SVZinoviev/radio-piper-lo-pll-hw/README.md

# 100 - 200 MHz PLL

## Intended use

Radio LO1 and LO2 configurable synthesizer.

## Configuration

VCO can work in the wide range 10 MHz - 200+ MHz
