SVZinoviev/radio-piper-lo-pll-hw/vco-100-200.kicad_pcb

## KiCad design vco-100-200.kicad_pcb (2026-02-13)

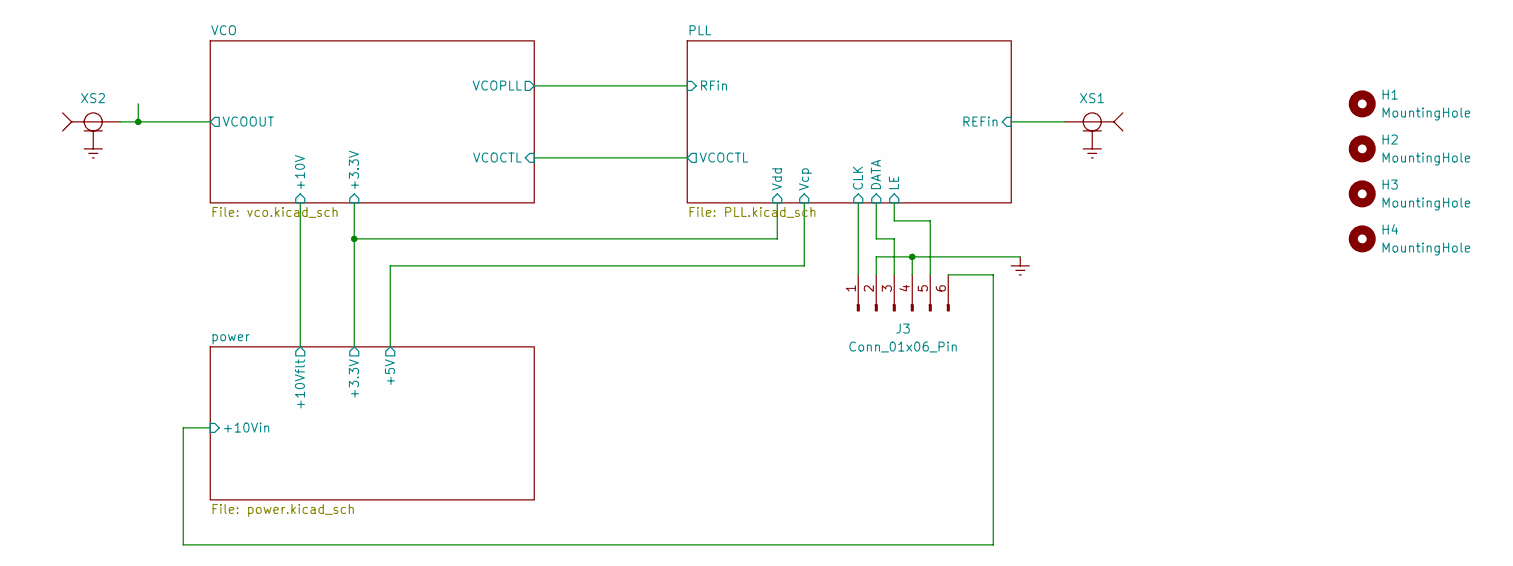
[picture p1: schematic vco-100-200.kicad_sch]

Parts:
H1, H2, H3, H4: MountingHole; MountingHole_3.2mm_M3
J3: Conn_01x06_Pin; PinHeader_1x06_P2.54mm_Vertical
XS1, XS2: RF-PCB-pin-place

Connections:
/PLL/CLK: J3.1; also elsewhere on the board
/PLL/DATA: J3.3; also elsewhere on the board
/PLL/LE: J3.5; also elsewhere on the board
/PLL/REFin: XS1.1; also elsewhere on the board
/VCO/VCOOUT: XS2.1; also elsewhere on the board
/power/+10Vin: J3.6; also elsewhere on the board
Earth: J3.2, J3.4, XS1.2, XS2.2; also elsewhere on the board

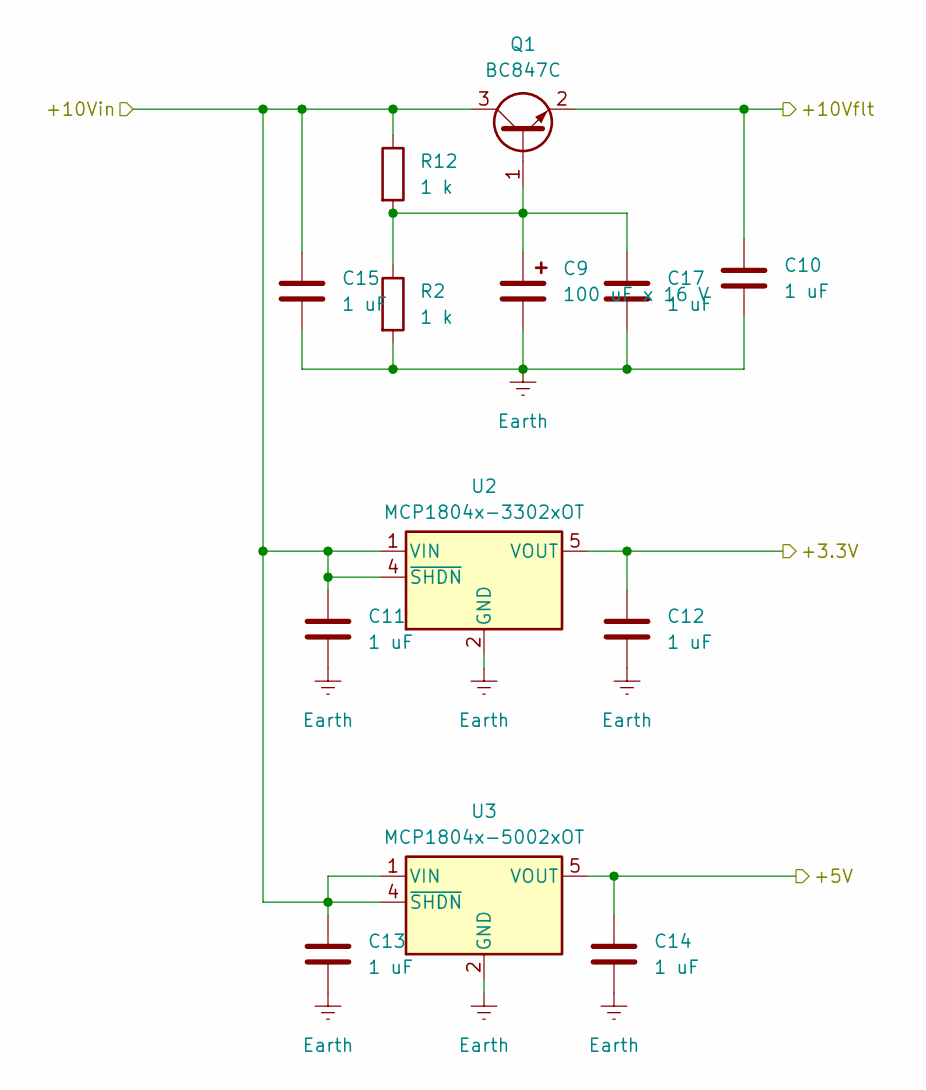
[picture p2: schematic power.kicad_sch]

Parts:
C9: 100 uF x 16 V; CP_Elec_6.3x5.8; Partnumber UCD1C101MCL1GS
C10, C11, C12, C13, C14, C15, C17: 1 uF; C_0603_1608Metric; Partnumber GCM188R71C105KA64D
Q1: BC847C; SOT-23; Partnumber BC847C
R2, R12: 1 k; R_0603_1608Metric; Partnumber RC0603JR-071K00L
U2: MCP1804x-3302xOT; SOT-23-5
U3: MCP1804x-5002xOT; SOT-23-5

Connections:
/PLL/Vcp: C14.1, U3.5 (VOUT); also elsewhere on the board
/PLL/Vdd: C12.1, U2.5 (VOUT); also elsewhere on the board
/VCO/+10V: C10.1, Q1.2 (E); also elsewhere on the board
/power/+10Vin: C11.1, C13.1, C15.1, Q1.3 (C), R12.1, U2.1 (VIN), U2.4 (~SHDN), U3.1 (VIN), U3.4 (~SHDN); also elsewhere on the board
Earth: C9.2, C10.2, C11.2, C12.2, C13.2, C14.2, C15.2, C17.2, R2.2, U2.2 (GND), U3.2 (GND); also elsewhere on the board
unnamed: C9.1, C17.1, Q1.1 (B), R2.1, R12.2

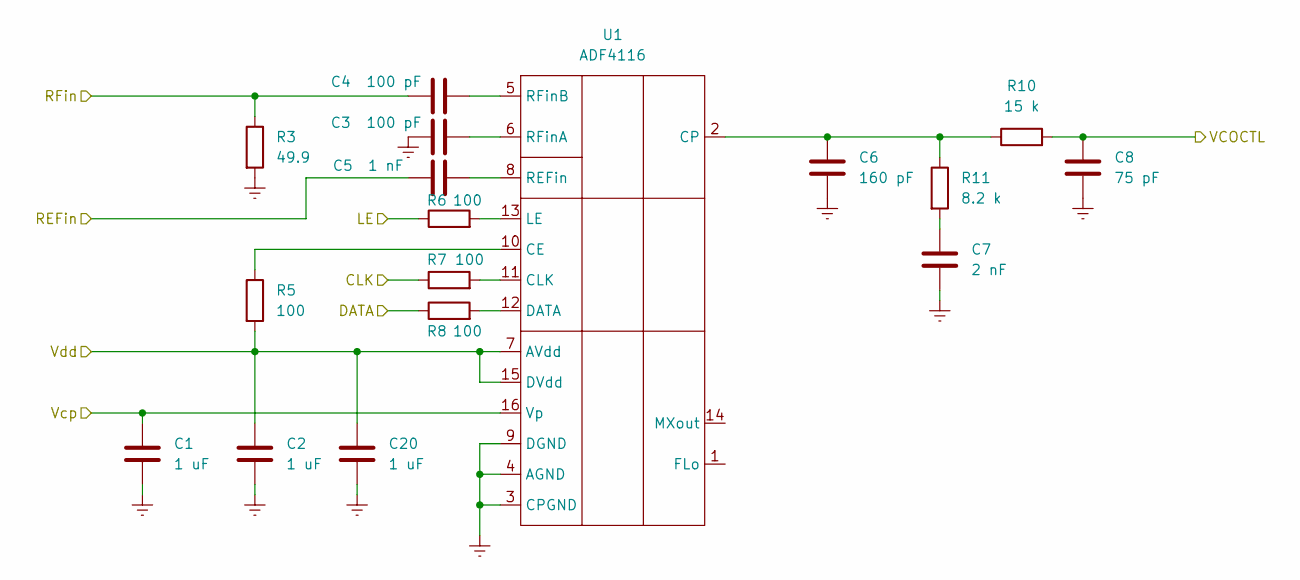
[picture p3: schematic PLL.kicad_sch]

Parts:
C1, C2, C20: 1 uF; C_0603_1608Metric; Partnumber GCM188R71C105KA64D
C3, C4: 100 pF; C_0603_1608Metric; Partnumber CC0603JRNPO9BN101
C5: 1 nF; C_0603_1608Metric; Partnumber CC0603JRNPO9BN102
C6: 160 pF; C_0603_1608Metric; Partnumber GCM1885C2A161GA16J
C7: 2 nF; C_0603_1608Metric; Partnumber GRM1885C1H222JA01D
C8: 75 pF; C_0603_1608Metric; Partnumber GCM1885C2A750JA16D
R3: 49.9; R_0603_1608Metric; Partnumber RC0603FR-0749R9L
R5, R6, R7, R8: 100; R_0603_1608Metric; Partnumber RC0603JR-07100RL
R10: 15 k; R_0603_1608Metric; Partnumber RC0603JR-0715K0L
R11: 8.2 k; R_0603_1608Metric; Partnumber RC0603FR-078K2L
U1: ADF4116; TSSOP-16_4.4x5mm_P0.65mm; Partnumber ADF4116BRUZ

Connections:
/PLL/CLK: R7.1; also elsewhere on the board
/PLL/DATA: R8.1; also elsewhere on the board
/PLL/LE: R6.1; also elsewhere on the board
/PLL/REFin: C5.2; also elsewhere on the board
/PLL/RFin: C4.1, R3.1; also elsewhere on the board
/PLL/VCOCTL: C8.1, R10.2; also elsewhere on the board
/PLL/Vcp: C1.1, U1.16 (Vp); also elsewhere on the board
/PLL/Vdd: C2.1, C20.1, R5.2, U1.7 (AVdd), U1.15 (DVdd); also elsewhere on the board
Earth: C1.2, C2.2, C3.1, C6.2, C7.2, C8.2, C20.2, R3.2, U1.3 (CPGND), U1.4 (AGND), U1.9 (DGND); also elsewhere on the board
unnamed: C7.1, R11.2
unnamed: R5.1, U1.10 (CE)
unnamed: R7.2, U1.11 (CLK)
unnamed: C6.1, R10.1, R11.1, U1.2 (CP)
unnamed: R8.2, U1.12 (DATA)
unnamed: R6.2, U1.13 (LE)
unnamed: C5.1, U1.8 (REFin)
unnamed: C3.2, U1.6 (RFinA)
unnamed: C4.2, U1.5 (RFinB)

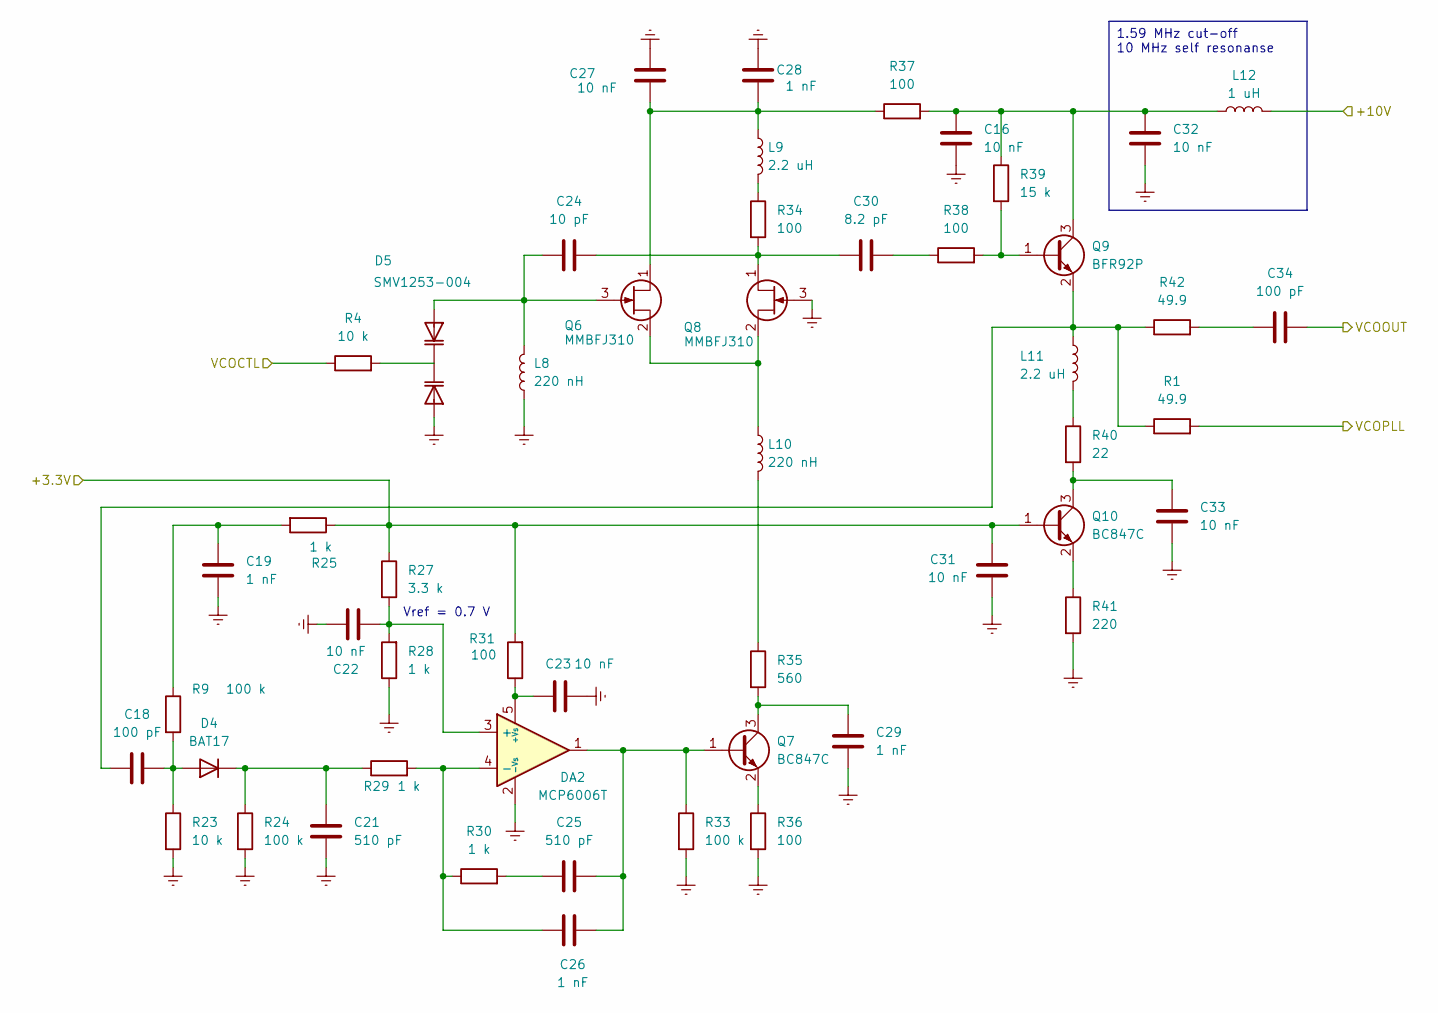
[picture p4: schematic vco.kicad_sch]

Parts:
C16, C22, C23, C27, C31, C32, C33: 10 nF; C_0603_1608Metric; Partnumber CC0603JRNPO9BN103
C18, C34: 100 pF; C_0603_1608Metric; Partnumber CC0603JRNPO9BN101
C19, C26, C28, C29: 1 nF; C_0603_1608Metric; Partnumber CC0603JRNPO9BN102
C21, C25: 510 pF; C_0603_1608Metric; Partnumber CC0603JRNPO9BN511
C24: 10 pF; C_0603_1608Metric; Partnumber CC0603JRNPO9BN100
C30: 8.2 pF; C_0603_1608Metric; Partnumber CC0603JRNPO9BN8R2
D4: BAT17; SOT-23; Partnumber BAT17E6327HTSA1
D5: SMV1253-004; SOT-23; Partnumber SMV1253-004LF
DA2: MCP6006T; SOT-23-5
L8, L10: 220 nH; L_1008_2520Metric; Partnumber LQW2BASR22J00L
L9, L11: 2.2 uH; L_1008_2520Metric; Partnumber LQW2UAS2R2J00L
L12: 1 uH; L_0603_1608Metric; Partnumber MLZ1608A1R0WT000
Q6, Q8: MMBFJ310; SOT-23; Partnumber MMBFJ310
Q7, Q10: BC847C; SOT-23; Partnumber BC847C
Q9: BFR92P; SOT-23; Partnumber BFR92PE6327HTSA1
R1, R42: 49.9; R_0603_1608Metric; Partnumber RC0603FR-0749R9L
R4, R23: 10 k; R_0603_1608Metric; Partnumber RC0603JR-0710K0L
R9, R24, R33: 100 k; R_0603_1608Metric; Partnumber RC0603JR-07100KL
R25, R28, R29, R30: 1 k; R_0603_1608Metric; Partnumber RC0603JR-071K00L
R27: 3.3 k; R_0603_1608Metric; Partnumber RC0603JR-073K30L
R31, R34, R36, R37, R38: 100; R_0603_1608Metric; Partnumber RC0603JR-07100RL
R35: 560; R_0603_1608Metric; Partnumber RC0603JR-07560RL
R39: 15 k; R_0603_1608Metric; Partnumber RC0603JR-0715K0L
R40: 22; R_0603_1608Metric; Partnumber RC0603JR-0722RL
R41: 220; R_0603_1608Metric; Partnumber RC0603JR-07220RL

Connections:
/PLL/RFin: R1.2; also elsewhere on the board
/PLL/VCOCTL: R4.1; also elsewhere on the board
/PLL/Vdd: C31.2, Q10.1 (B), R25.1, R27.1, R31.2; also elsewhere on the board
/VCO/+10V: L12.2; also elsewhere on the board
/VCO/VCOOUT: C34.2; also elsewhere on the board
Earth: C16.2, C19.2, C21.1, C22.1, C23.2, C27.2, C28.2, C29.2, C31.1, C32.2, C33.2, D5.2 (A2), DA2.2 (-Vs), L8.1, Q8.3 (G), R23.2, R24.2, R28.1, R33.2, R36.2, R41.2; also elsewhere on the board
unnamed: C19.1, R9.1, R25.2
unnamed: C25.1, R30.2
unnamed: C30.2, R38.1
unnamed: C34.1, R42.2
unnamed: C18.2, D4.1 (A), R9.2, R23.1
unnamed: C21.2, D4.3 (K), R24.1, R29.1
unnamed: C24.1, D5.1 (A1), L8.2, Q6.3 (G)
unnamed: D5.3 (K), R4.2
unnamed: C22.2, DA2.3 (+), R27.2, R28.2
unnamed: C23.1, DA2.5 (+Vs), R31.1
unnamed: C26.1, DA2.4 (-), R29.2, R30.1
unnamed: L9.2, R34.1
unnamed: L10.2, R35.1
unnamed: L11.2, R40.1
unnamed: C27.1, C28.1, L9.1, Q6.1 (D), R37.1
unnamed: L10.1, Q6.2 (S), Q8.2 (S)
unnamed: C25.2, C26.2, DA2.1, Q7.1 (B), R33.1
unnamed: C29.1, Q7.3 (C), R35.2
unnamed: Q7.2 (E), R36.1
unnamed: C24.2, C30.1, Q8.1 (D), R34.2
unnamed: Q9.1 (B), R38.2, R39.2
unnamed: C16.1, C32.1, L12.1, Q9.3 (C), R37.2, R39.1
unnamed: C18.1, L11.1, Q9.2 (E), R1.1, R42.1
unnamed: C33.1, Q10.3 (C), R40.2
unnamed: Q10.2 (E), R41.1

Notes on the sheet:
Vref = 0.7 V
1.59 MHz cut-off 10 MHz self resonanse

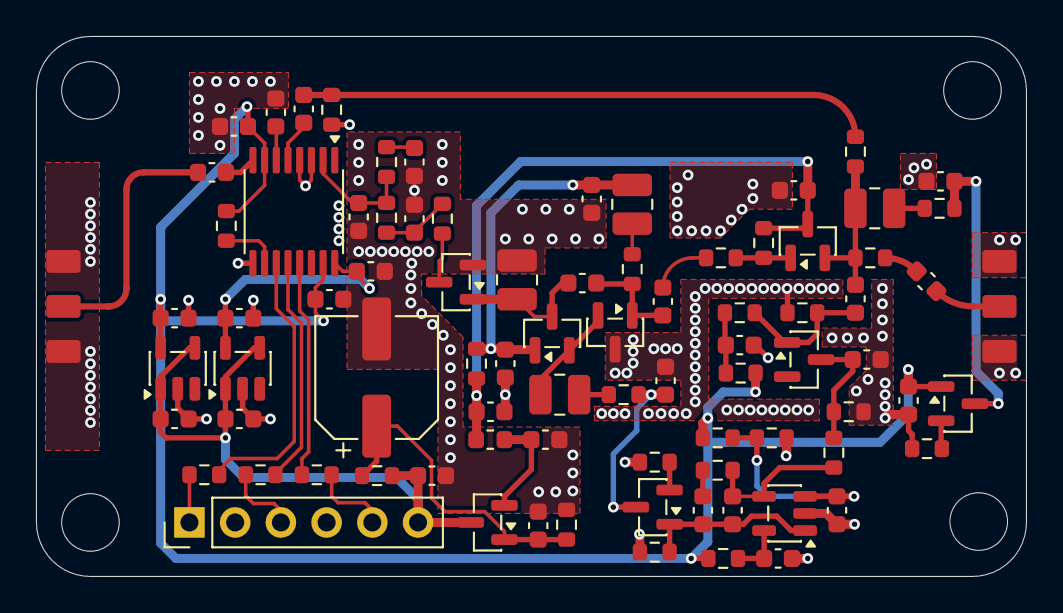
[picture p5: board vco-100-200.kicad_pcb from above]

Board: 4 copper layers, 55.0 x 30.0 mm, 88 parts (0 on the bottom side), 47 nets.
