SVZinoviev/radio-piper-lo-pll-hw/(commit log)

2026-02-12 Add project files to the repo. Initial version
    [PLL.kicad_sch, power.kicad_sch, vco-100-200.kicad_pcb, vco-100-200.kicad_sch, vco.kicad_sch]
2026-02-13 Update pcb routing, add 50 Ohm net classes
    [vco-100-200.kicad_pcb, vco-100-200.kicad_sch]
